cvetaevvitaliy/OpenPixelOSD/Cube/OpenPixelOSD.png

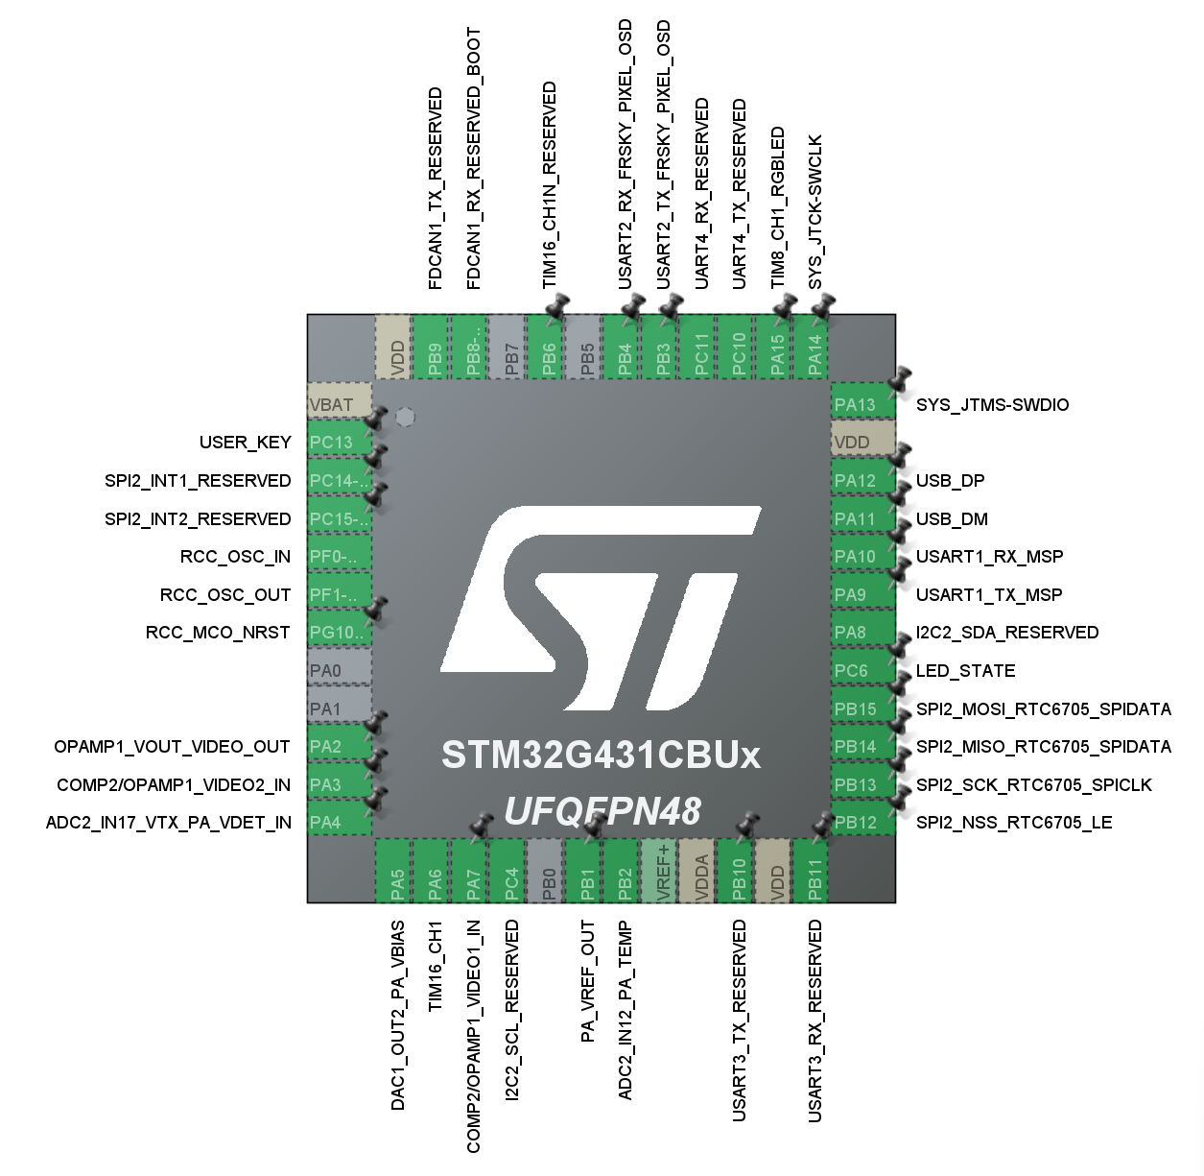
Cube/OpenPixelOSD.png
