cvetaevvitaliy/OpenPixelOSD/python/osd_fonts/betaflight_color.png

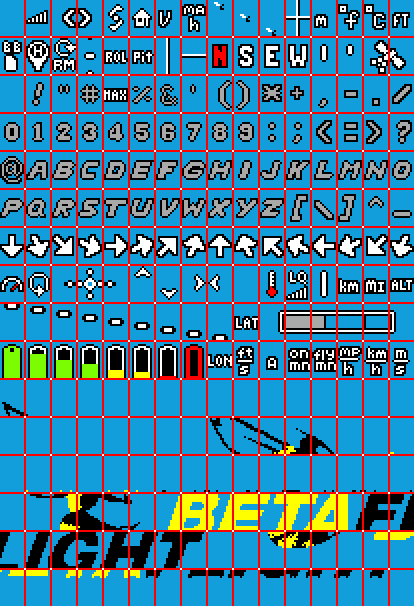
python/osd_fonts/betaflight_color.png
