cvetaevvitaliy/OpenPixelOSD/python/osd_fonts/bold_color.png

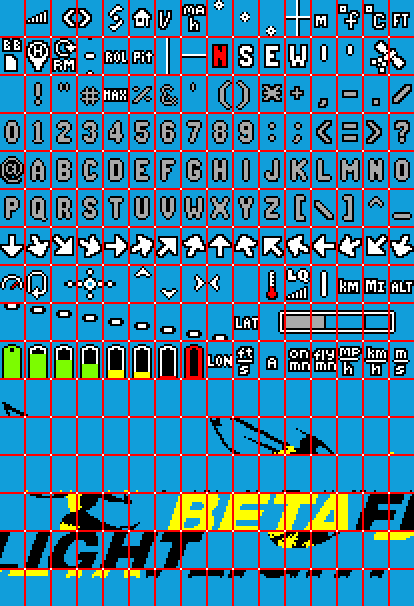
python/osd_fonts/bold_color.png
