cvetaevvitaliy/OpenPixelOSD/python/osd_fonts/clarity_color.png

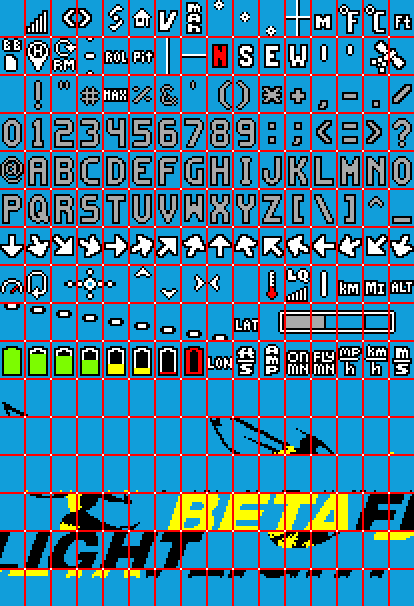
python/osd_fonts/clarity_color.png
