cvetaevvitaliy/OpenPixelOSD/python/osd_fonts/default_color.png

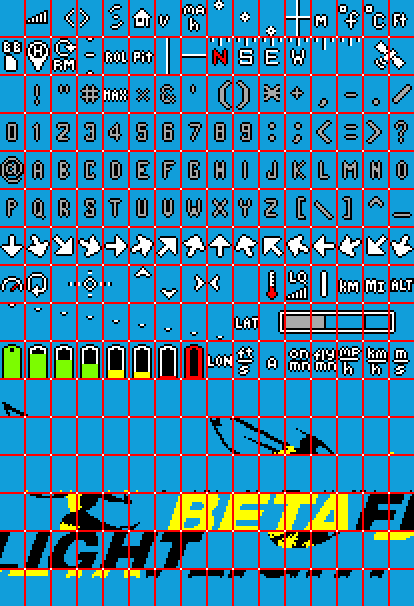
python/osd_fonts/default_color.png
