cvetaevvitaliy/OpenPixelOSD/python/osd_fonts/digital_color.png

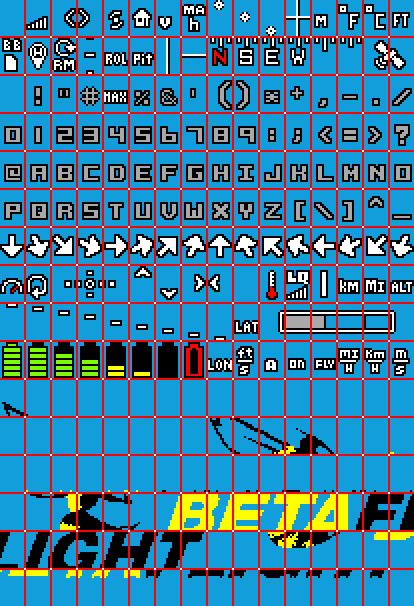
python/osd_fonts/digital_color.png
