cvetaevvitaliy/OpenPixelOSD/python/osd_fonts/extra_large_color.png

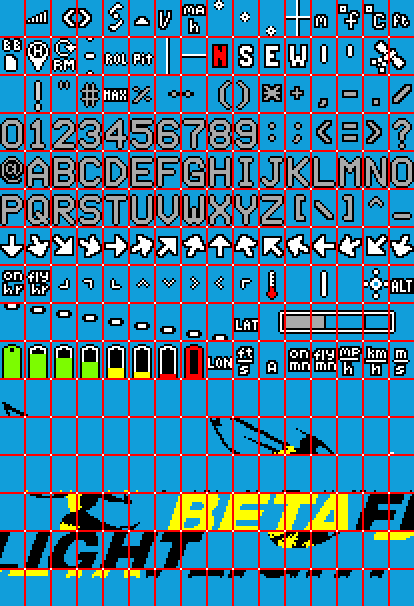
python/osd_fonts/extra_large_color.png
