cvetaevvitaliy/OpenPixelOSD/python/osd_fonts/impact_color.png

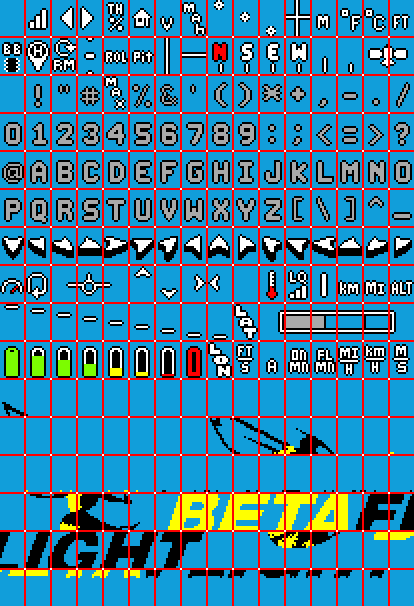
python/osd_fonts/impact_color.png
