cvetaevvitaliy/OpenPixelOSD/python/osd_fonts/impact_mini_color.png

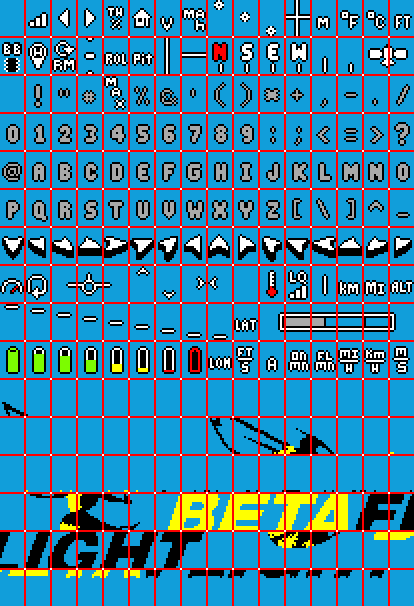
python/osd_fonts/impact_mini_color.png
