cvetaevvitaliy/OpenPixelOSD/doc/OpenPixelOSD.drawio.pdf

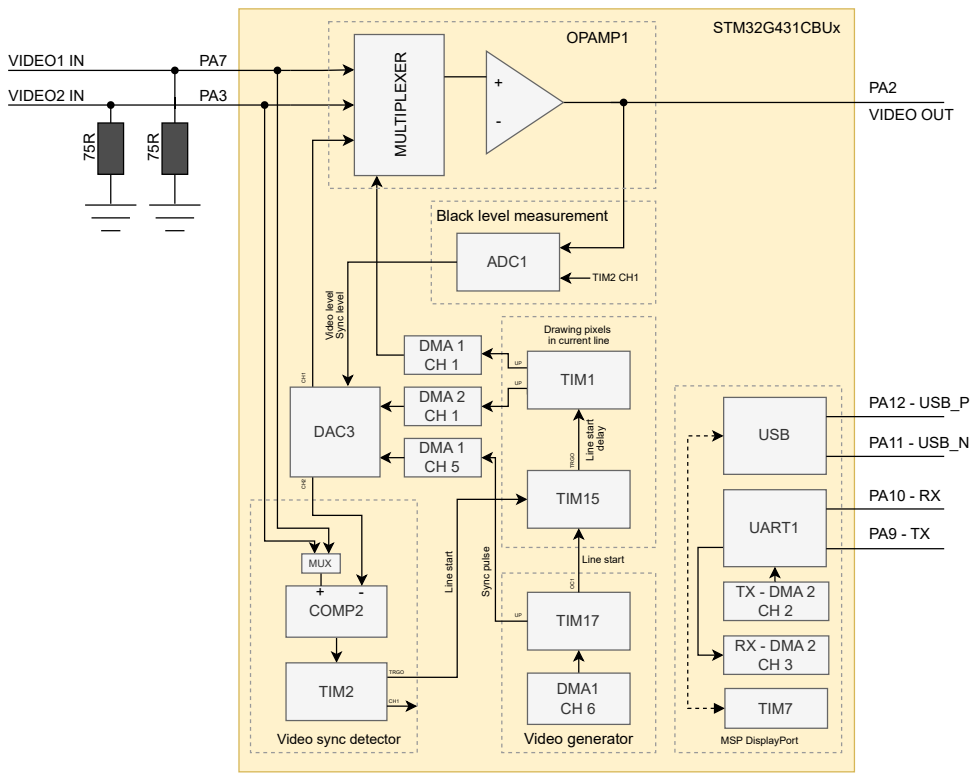
[picture p13: page 1]
STM32G431CBUx; VIDEO2 IN; VIDEO OUT; TIM1; DMA 2 CH 1; DMA 1 CH 1; TIM15; Line start; UART1; TX - DMA 2 CH 2; RX - DMA 2 CH 3; MSP DisplayPort; USB; TIM7; PA12 - USB_P; DMA 1; PA11 - USB_N; Line start delay; TIM17; Video generator; DMA1; CH 6 OC¹; COMP2; TIM2; TRGO; MUX; Sync pulse; ADC1; TIM2 CH1; MULTIPLEXER; OPAMP1; DAC3; VIDEO1 IN; Video level Sync level

Black level measurement

Drawing pixels
in current line

Video sync detector
