cvetaevvitaliy/OpenPixelOSD/Cube/OpenPixelOSD.ioc

Mcu.UserName=STM32G431CBUx
PA10.GPIO_Label=USART1_RX_MSP
PA10.Signal=USART1_RX
PA11.Signal=USB_DM
PA12.Signal=USB_DP
PA13.Signal=SYS_JTMS-SWDIO
PA14.Signal=SYS_JTCK-SWCLK
PA15.GPIO_Label=TIM8_CH1_RGBLED
PA15.Signal=S_TIM8_CH1
PA2.GPIO_Label=OPAMP1_VOUT_VIDEO_OUT
PA2.Signal=OPAMP1_VOUT
PA3.GPIO_Label=COMP2/OPAMP1_VIDEO2_IN
PA3.Signal=GPIO_Analog
PA4.GPIO_Label=ADC2_IN17_VTX_PA_VDET_IN
PA4.Signal=ADC2_IN17
PA5.GPIO_Label=DAC1_OUT2_PA_VBIAS
PA5.Signal=COMP_DAC12_group
PA6.Signal=S_TIM16_CH1
PA7.GPIO_Label=COMP2/OPAMP1_VIDEO1_IN
PA7.Signal=SharedAnalog_PA7
PA8.GPIO_Label=I2C2_SDA_RESERVED
PA8.Signal=I2C2_SDA
PA9.GPIO_Label=USART1_TX_MSP
PA9.Signal=USART1_TX
PB1.GPIO_Label=PA_VREF_OUT
PB1.Signal=GPIO_Output
PB10.GPIO_Label=USART3_TX_RESERVED
PB10.Signal=USART3_TX
PB11.GPIO_Label=USART3_RX_RESERVED
PB11.Signal=USART3_RX
PB12.GPIO_Label=SPI2_NSS_RTC6705_LE
PB12.Signal=SPI2_NSS
PB13.GPIO_Label=SPI2_SCK_RTC6705_SPICLK
PB13.Signal=SPI2_SCK
PB14.GPIO_Label=SPI2_MISO_RTC6705_SPIDATA
PB14.Signal=SPI2_MISO
PB15.GPIO_Label=SPI2_MOSI_RTC6705_SPIDATA
PB15.Signal=SPI2_MOSI
PB2.GPIO_Label=ADC2_IN12_PA_TEMP
PB2.Signal=ADC2_IN12
PB3.GPIO_Label=USART2_TX_FRSKY_PIXEL_OSD
PB3.Signal=USART2_TX
PB4.GPIO_Label=USART2_RX_FRSKY_PIXEL_OSD
PB4.Signal=USART2_RX
PB6.GPIO_Label=TIM16_CH1N_RESERVED
PB6.Signal=TIM16_CH1N
PB8-BOOT0.GPIO_Label=FDCAN1_RX_RESERVED_BOOT
PB8-BOOT0.Signal=FDCAN1_RX
PB9.GPIO_Label=FDCAN1_TX_RESERVED
PB9.Signal=FDCAN1_TX
PC10.GPIO_Label=UART4_TX_RESERVED
PC10.Signal=UART4_TX
PC11.GPIO_Label=UART4_RX_RESERVED
PC11.Signal=UART4_RX
PC13.GPIO_Label=USER_KEY
PC13.Signal=GPIO_Input
PC14-OSC32_IN.GPIO_Label=SPI2_INT1_RESERVED
PC14-OSC32_IN.Signal=GPXTI14
PC15-OSC32_OUT.GPIO_Label=SPI2_INT2_RESERVED
PC15-OSC32_OUT.Signal=GPXTI15
PC4.GPIO_Label=I2C2_SCL_RESERVED
PC4.Signal=I2C2_SCL
PC6.GPIO_Label=LED_STATE
PC6.Signal=GPIO_Output
PF0-OSC_IN.Signal=RCC_OSC_IN
PF1-OSC_OUT.Signal=RCC_OSC_OUT
PG10-NRST.GPIO_Label=RCC_MCO_NRST
PG10-NRST.Signal=RCC_MCO
