cvetaevvitaliy/OpenPixelOSD/(commit log)

2026-09-17 Changes to support VTX-Tool and VTX calibration (#34)
2026-09-17 Support dynamic power levels and frequencies.
2026-09-17 Allow a single calibration point.
    * useful for when the calibration tool only has one frequency, such as the ImmersionRC Power Meter V1.
2026-09-18 Update dma UART3 added
2026-09-18 Reboot to ROM bootloader added
    [main.c]
2026-09-18 FC status for camera control and stick commands added
2026-09-18 Debug PA overlay fixed
    [rf_pa.c]
2026-09-18 Adapt STM32G474 CCMRAM size
2026-09-18 Settings menu color fixed
    [canvas_char.c, canvas_char.h, settingsMenu.c]
